basel-sh/CNN_Accelerator/Presentation/README.md

# Presentation/

Reserved for the final competition deliverable: slide deck, architecture
diagrams, and result plots (FoM, utilization, timing, power summaries),
assembled at Phase 14 - Final Report (see
`Documentation/DevelopmentRoadmap.md`). Empty until Phases 10-13 produce
real synthesis/timing/power numbers to present.
