basel-sh/CNN_Accelerator/Final_Report_SiliconMinds.docx

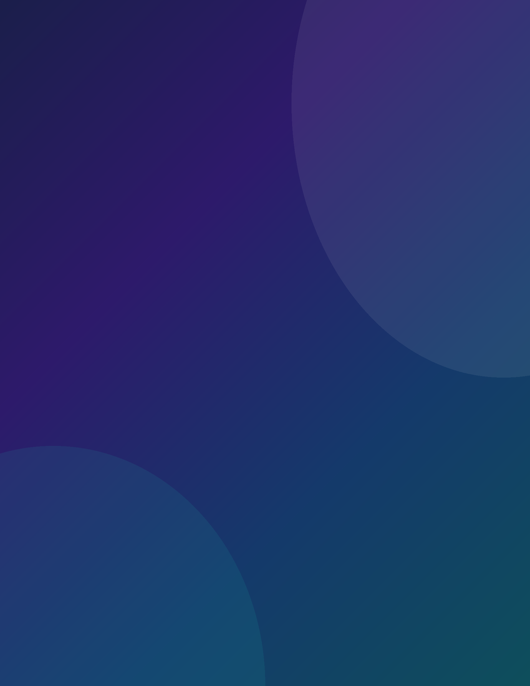
[picture p6: figure]

IEEE SSCS EGYPT CHAPTER 2026

STUDENT DESIGN COMPETITION - FINAL REPORT

- Silicon Minds - FPGA CNN Convolution Accelerator

2 px/cycle - Zero-DSP - Kernel-Scoped Bit-Width Datapath

FINAL FIGURE OF MERIT

1.777 x 10⁻²

Team Silicon Minds

Basel Shrief - Design, Verification Plan and Python Tooling by one engineer

github.com/basel-sh/CNN_Accelerator

Target Device: Xilinx Artix-7 xc7a35tcpg236-1 | September 2026

Contents

01. Executive Summary 1

02. Introduction and Requirements 2

03. System Architecture 3

04. Design-Space Exploration 6

05. Verification Methodology and Results 7

06. Kernel-Scoped Bit-Width Optimization 8

07. Synthesis and Implementation Results 9

08. Figure of Merit Analysis 10

09. Project Timeline 11

10. Requirements Traceability 12

11. Verification Methods 13

12. Output Generation 15

13. Team and Repository 19

14. Competition Required Results Table 20

Repository: github.com/basel-sh/CNN_Accelerator

# 01. Executive Summary

This report documents an FPGA-based NxN CNN convolution accelerator built for the IEEE SSCS Egypt Chapter 2026 Student Design Competition, and the full engineering path that produced it - five real, measured design phases, not a single guess that happened to work.

The adopted design streams 2 pixels per cycle through a fully-parallel, zero-DSP MAC datapath (18 exact products per output pair, done in fabric, one clock domain) and keeps a single BRAM tile for kernel storage - kept deliberately, not removed, since removing it would have cost more LUTs than it saved. The final optimization phase restricts kernel coefficients to |coeff| <= 8 and trims the accumulator from 20 to 16 bits, since the true worst-case 9-term sum (18,360) still fits safely under the 16-bit signed range (32,768). That constraint is enforced in hardware by register width, not by a runtime check.

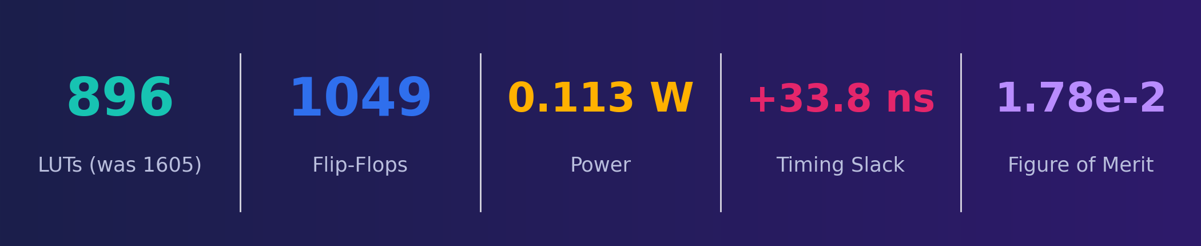
[picture p7: figure]

Figure 1: Final routed results, Artix-7 xc7a35tcpg236-1

Reaching this result took two dead ends and one deliberate step backward.
A 1-pixel/cycle baseline (842 LUT, FoM 7.52e-3) was doubled to 2 pixels/cycle first using 4 shared DSP48 slices on a second 120 MHz clock - it verified functionally (900/900 bit-exact) but never closed timing (WNS -4.338 ns) and was abandoned.
A fully-parallel zero-DSP version was adopted instead (1411 LUT, FoM 1.10x10⁻², first positive-WNS 2px result).
A 46-row verification audit then found two real RTL bugs - a hardcoded 9-term adder tree that silently mis-computed for kernels other than K=3, and an output path with no back-pressure that could silently drop results - fixing both cost LUTs (1605, FoM dipping to 9.61 x10⁻³) before the kernel-scoped bit-width pass recovered and then exceeded every prior result (896 LUT, FoM 1.777 x10⁻²).
Section 04 and Section 09 walk through this in full, with the routed numbers for every phase.

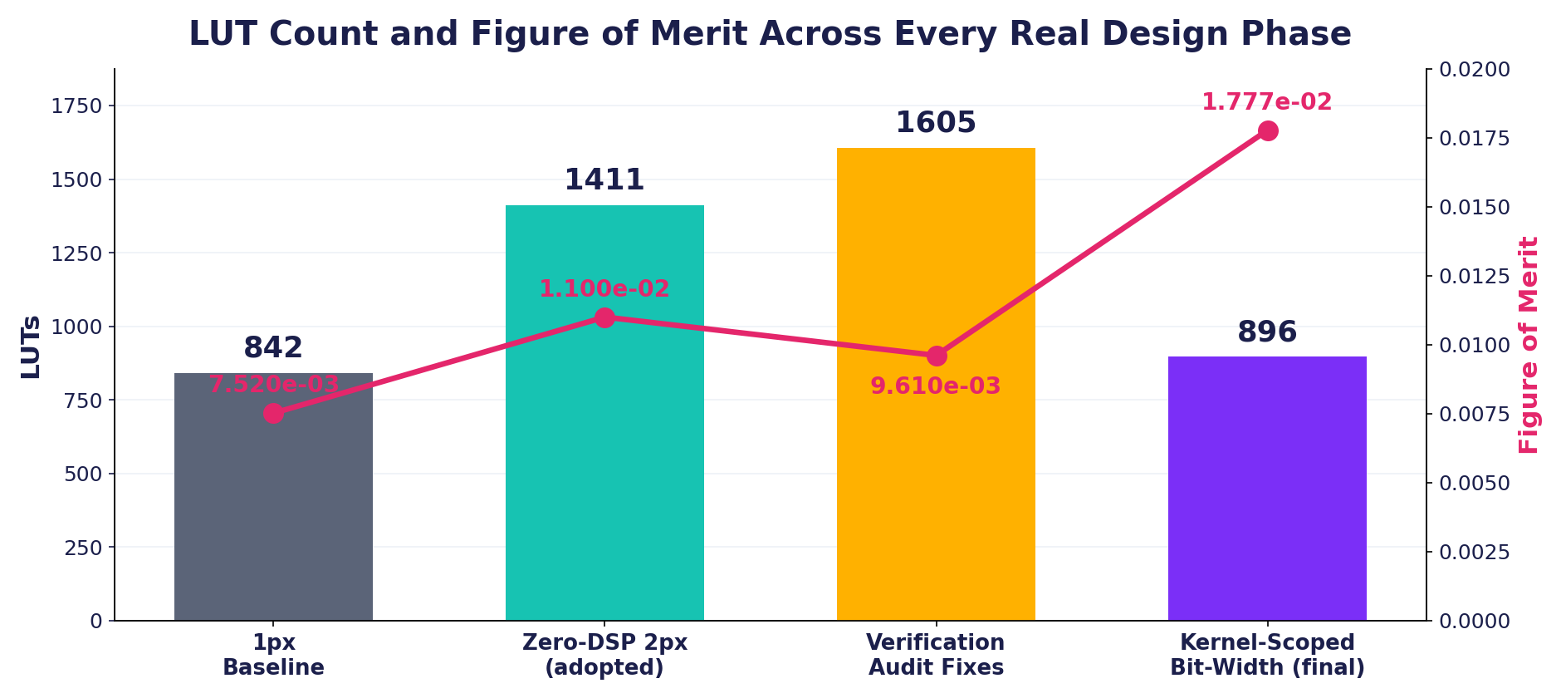
[picture p8: figure]

Figure 2: Comparison of the FoM with respect to the LUT over time

# 02. Introduction and Requirements

The competition specifies a programmable convolution accelerator for grayscale images or CNN feature maps:

1. Unsigned fixed-point pixel input
2. A programmable NxN kernel with signed 8-bit coefficients
3. Stride 1
4. An optional ReLU activation
5. Minimum 16-bit signed output.
7. Designs are scored on a single Figure of Merit:

Figure of Merit

FoM = (Throughput)/(Power x (LUTs + 50xDSPs + 100xBRAMs)) in output pixels/cycle. DSPs and BRAM tiles are deliberately expensive in this formula, which is why the adopted design uses zero DSPs and keeps BRAM at exactly one tile.

Requirement | Status
Min. 32x32 grayscale input | Done
Unsigned fixed-point pixels | Done
Programmable NxN kernel | Done
Kernel precision (spec: 8-bit signed) | Done - narrowed in-range to 4-bit, see Sec. 06
Stride = 1 | Done
Output precision (spec: min. 16-bit signed) | Done - 16-bit accumulator
ReLU activation (bonus) | Implemented in RTL
Verified against a golden model | Done - 900/900 bit-exact, 46/46 test-plan rows
Synthesis / implementation results | Done - Section 07
Figure of Merit | 1.777 x 10⁻² - Section 08

# 03. System Architecture

Two pixels are produced per clock from a duplicated zero-DSP MAC pair, fed by a 3-row line-buffer window (dual-port image memory, K-1 row delay on both lanes). Kernel coefficients are 4-bit signed values (|coeff| <= 8) and accumulation happens in a 16-bit register before saturation to the output width.

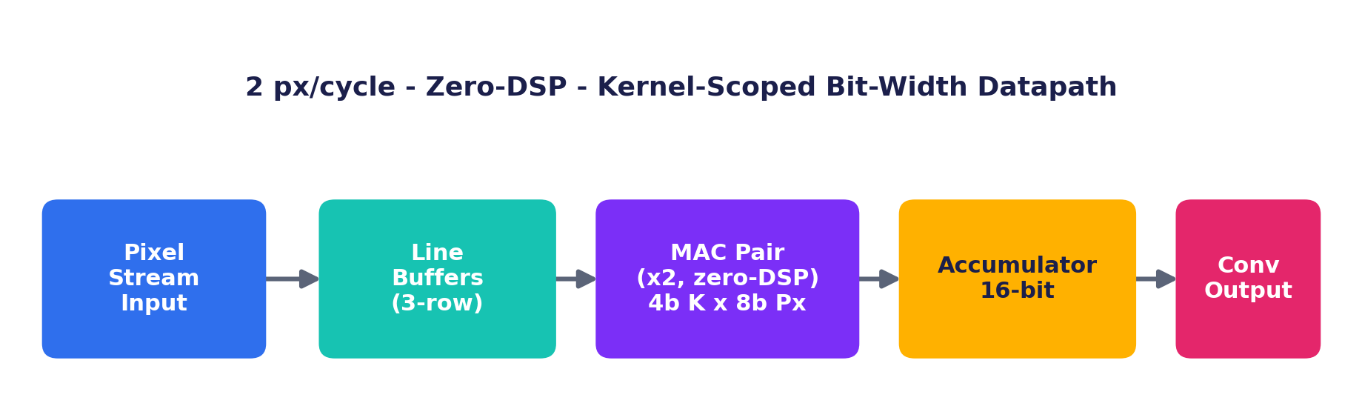
[picture p9: figure]

Figure 3: Sysem Architecture

Parameter | Value
Pixels / cycle | 2
Exact products per output pair | 18 (9 per output x 2 lanes)
DSP slices used | 0 - all products done in fabric
BRAM tiles | 1 (kept, not removed - see Sec. 04)
Kernel_W | 4-bit (spec allows 8-bit)
Acc_W | 16-bit (spec minimum 16-bit)
Clock | Single 20 MHz domain, no CDC logic anywhere
Target device | Xilinx Artix-7 xc7a35tcpg236-1

Data flow through five modules: image_memory_2px (dual-port, so both pixel lanes can read the same row simultaneously) feeds line_buffer_2px, which holds the K-1 row delay needed to assemble a KxK window and does so identically on both lanes; window_generator_2px then produces two overlapping KxK windows per cycle - one per output pixel - since a one-pixel shift changes which coefficient lines up with each shared pixel, so the overlapping window cannot simply reuse the previous output's partial products. Each window feeds its own instance of mac_pair.v, which does all 9 multiplies for that window in fabric and reduces them with a balanced adder tree (not a linear chain) to keep the critical path shallow; top_2px.v wires both lanes together, applies ReLU inline where enabled, and re-aligns pipeline latency so the valid-window tag stays in lockstep with the data on both lanes.

Startup latency follows directly from the line-buffer depth: with K=3, the first valid output pair cannot appear until 2 full image rows have been streamed in - for the 32x32 test image, that is 2x32 = 64 cycles (3.2 microseconds at 20 MHz) - plus a small, fixed number of register stages through window generation, the MAC adder tree, and the output/ReLU stage. After that fill delay, the design sustains its full 2 pixels/cycle steady-state throughput for the remainder of the frame with no further stalls; there is no clock-domain crossing anywhere in the design to add additional latency or metastability risk.

Waveform evidence (design behavior):

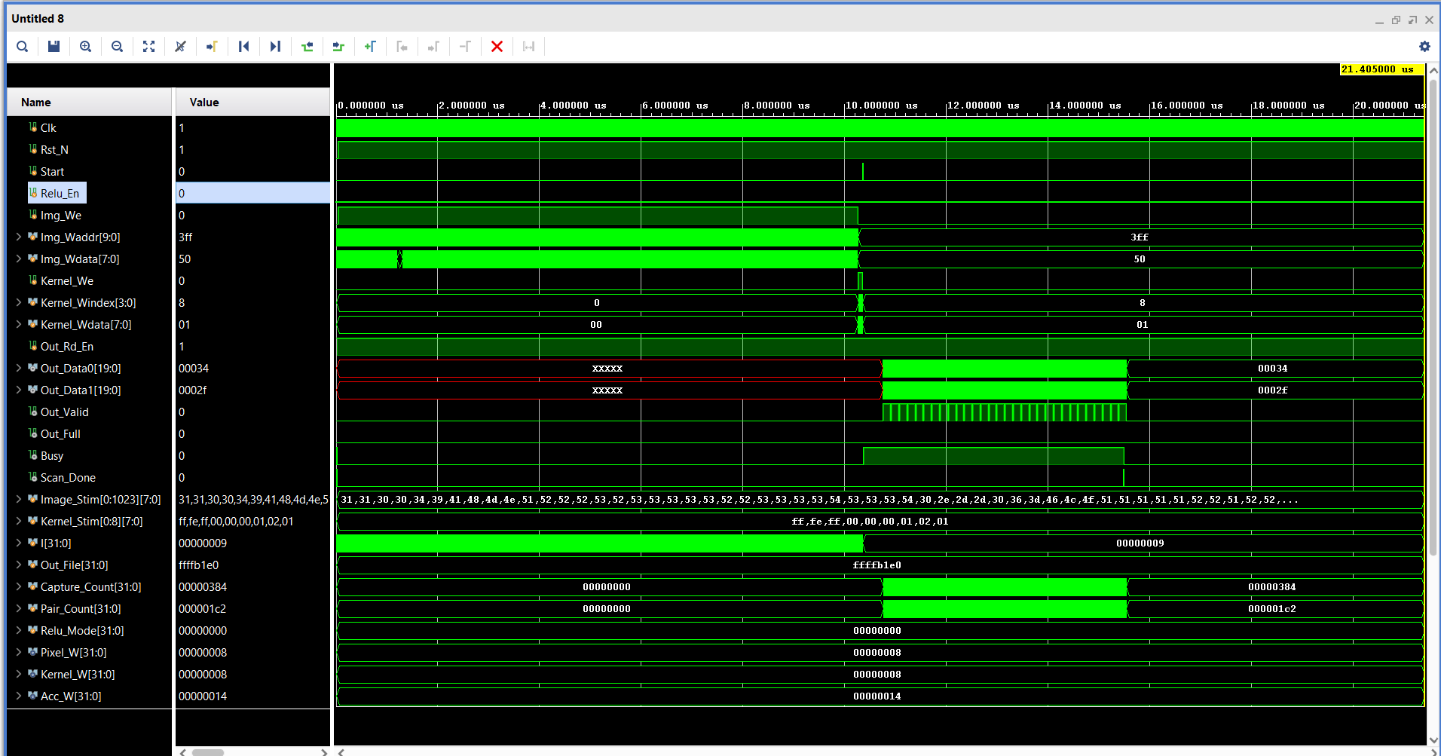
[picture p10: figure]

Figure 4: Wave simulation

# 04. Design-Space Exploration

Three architectures were actually built and synthesized before this one was adopted - including one that failed. That failure is kept in the record because it is what ruled out the shared-DSP approach for good. The 1px baseline (842 LUT, 758 FF, 0.149 W, WNS +35.538 ns, FoM 7.52 x10⁻³) was the first competition-ready design.
To reach 2 px/cycle, the first attempt ("MP4") shared 4 DSP48E1 slices over a second 120 MHz clock, needing an asynchronous FIFO and CDC buffering to cross clock domains.

Figure 5: Power Comparison

Figure 6: LUT Comparison

Figure 7: WNS Comparison

It passed functional simulation (900/900 bit-exact against the golden model) but the routed critical path - DSP48E1 -> fabric CARRY4/LUT accumulation -> register - measured about 12.6 ns against an 8.3 ns budget, missing timing by 4.338 ns with 118 failing endpoints. Its provisional FoM of 8.269 x10⁻³ was never a valid.

Routed result: 1411 LUT, 638 FF, 0 DSP, 1.0 BRAM, 0.120 W, WNS +35.076 ns, FoM 1.10 x10⁻³ - the first genuinely timing-closed 2px/cycle result in the project, and +46.6% over the 1px baseline.

Why BRAM was not removed

Removing the single 1.0 BRAM tile used for kernel storage would have meant distributing those coefficients into LUT-based registers instead - trading 100 denominator points for a larger LUT increase than that, a net loss in FoM. It was kept in place on purpose.

# 05. Verification Methodology and Results

Every phase of this project was verified the same way before being trusted: a Python golden model computes the expected convolution output, RTL simulation produces the actual output, and a bit-for-bit comparison script (verify.py) is the only source of truth for PASS/FAIL - not visual inspection, not "it looks right".

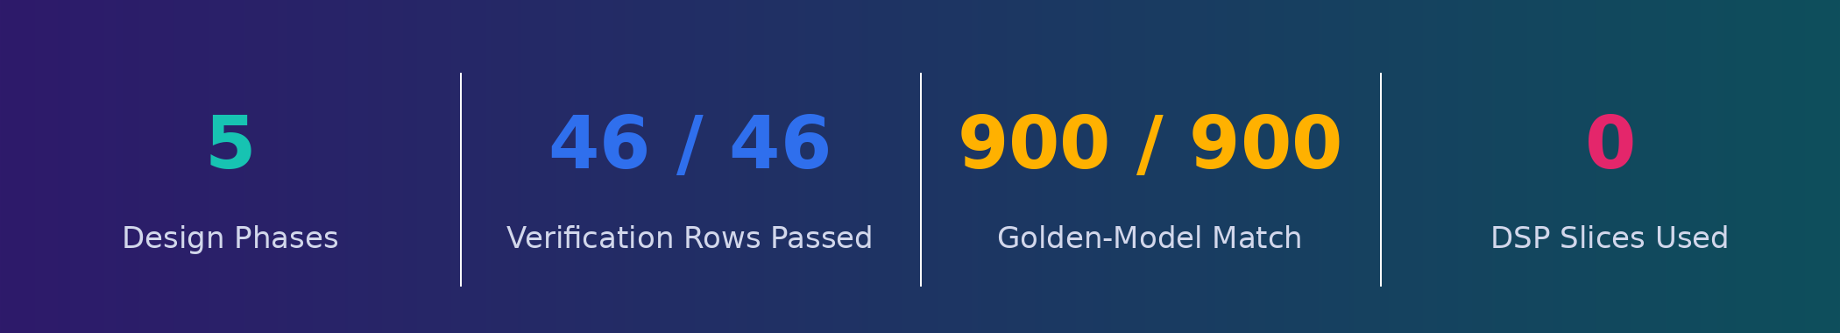
[picture p11: figure]

Figure 8: Verification output methodology

- Demo kernel (vertical-Sobel), ReLU off - 900/900 outputs bit-exact.
- Alternate real input photo, same kernel - 900/900 bit-exact.
- Alternate kernel (horizontal-Sobel, hand-edited into prepare_stimulus.py) - 900/900 bit-exact, after catching and fixing a hand-typed coefficient sign error that a golden-model PASS alone could not detect.

A 46-row formal verification test plan (Verification_Test_Plan.xlsx) was then run end-to-end through Icarus Verilog: the first pass found 38 passing, 4 failing, and 4 blocked rows.

The failures were real bugs, not test-plan errors: mac_pair.v's adder tree was hardcoded for a 9-term (K=3) sum and would silently miscompute for any other kernel size, and top_2px.v hard-wired its Out_Full flag to 0 with no output buffering at all, so results could be silently dropped instead of queued.
Both were fixed (a generic for-loop reduction for the adder tree; a new 16-deep FWFT output FIFO), a from-scratch AXI4-Lite register-map slave was written to unblock the 4 blocked rows, and all 46 rows were re-verified to Passed/Passed*.

A single-command regression runner (run_all.py) was then built so the entire plan can be
re-checked with one command instead of by hand.

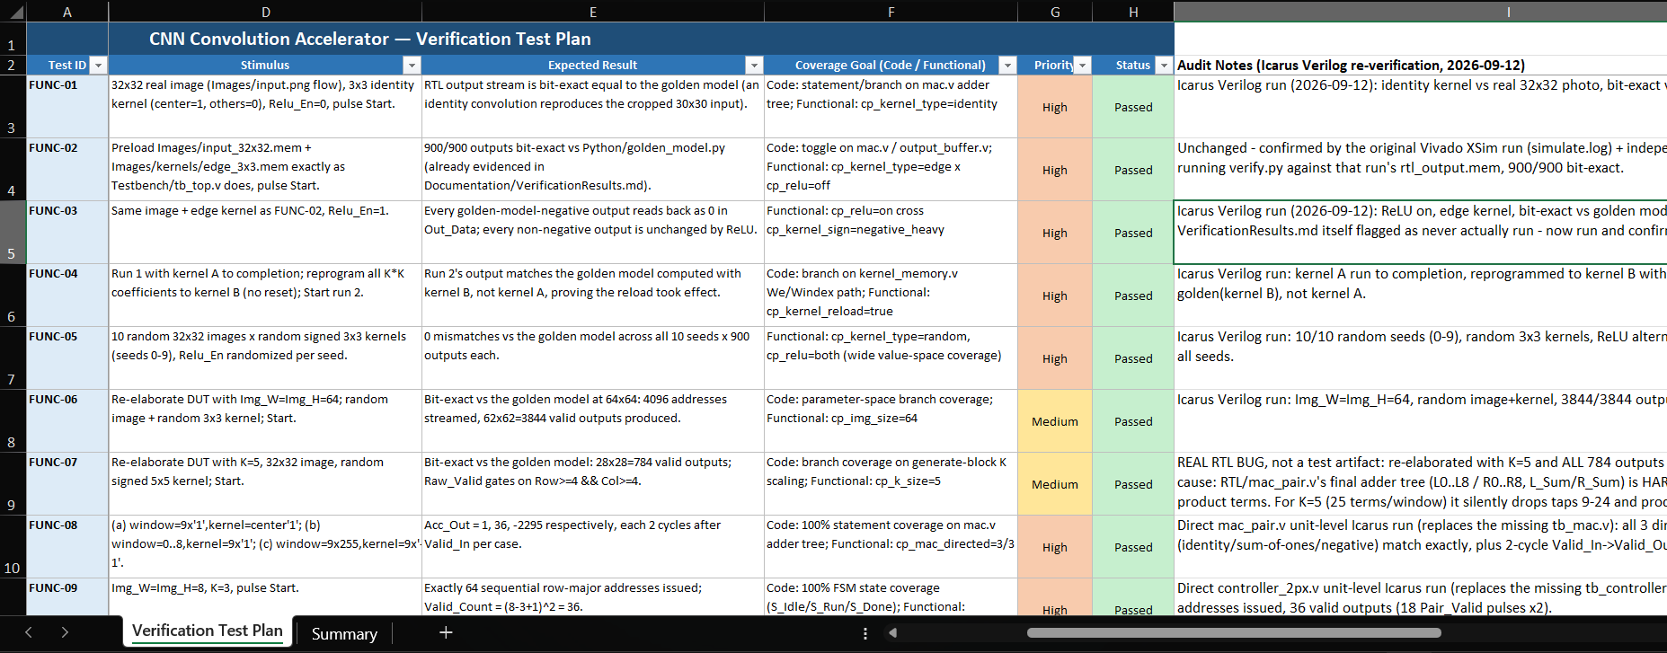
[picture p12: figure]

Spreadsheet evidence (formal test plan):

Figure 9: Verification Sheet

# 06. Kernel-Scoped Bit-Width Optimization

The verification-audit fixes above were correct but not free: LUT usage rose from 1411 to 1605 to buy real correctness (the generic adder tree and the output FIFO both cost fabric).

This phase's goal was to recover that cost and go further, by no longer paying for bit-width the kernel never

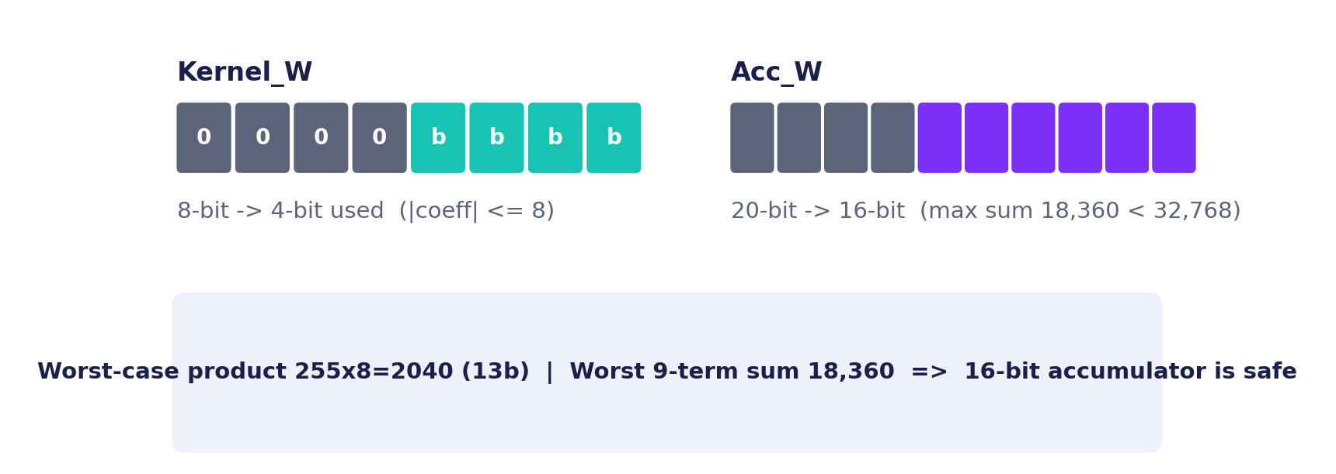
[picture p13: figure]

Figure 10: Kernal Scoped Bit-Width Optimization

Overflow safety proof

Worst-case product = 255 x 8 = 2,040 (fits in 13 bits, well under the 4x8=32-bit naive bound).
Worst-case 9-term accumulation = 9 x 2,040 = 18,360, comfortably under the 16-bit signed range (32,768).
No overflow risk is introduced by the narrower accumulator.

The |coeff| <= 8 restriction is hardware-enforced by the narrowed register width in kernel_memory.v and mac_pair.v - an out-of-range coefficient simply cannot be stored, it is not merely flagged at runtime.

RTL, testbench (tb_top_2px.v) and the Python golden model (prepare_stimulus.py, verify.py) were all updated to the new widths together and re-verified bit-exact before this result was trusted.

Figure 11: LUT Usage

# 07. Synthesis and Implementation Results

Metric | Before (1605 LUT) | After (896 LUT)
LUTs | 1605 | 896
Flip-Flops | 1288 | 1049
DSP slices | 0 | 0
BRAM tiles | 1 | 1
Power (total) | 0.122 W | 0.113 W
WNS (timing slack) | +32.627 ns | +33.802 ns
Figure of Merit | 9.61 x 10⁻³ | 1.777 x 10⁻²

For reference, the routed utilization report at the 1605-LUT checkpoint breaks the logic down as 1573 LUTs as logic plus 32 as shift-register memory, 1288 flip-flops (529 with async reset, 759 with sync reset), 80 F7 muxes and 40 F8 muxes, and a power split of 0.051 W dynamic against 0.070 W static at 0.122 W total - the same Vivado report_utilization / report_power methodology used to confirm every number in this report.

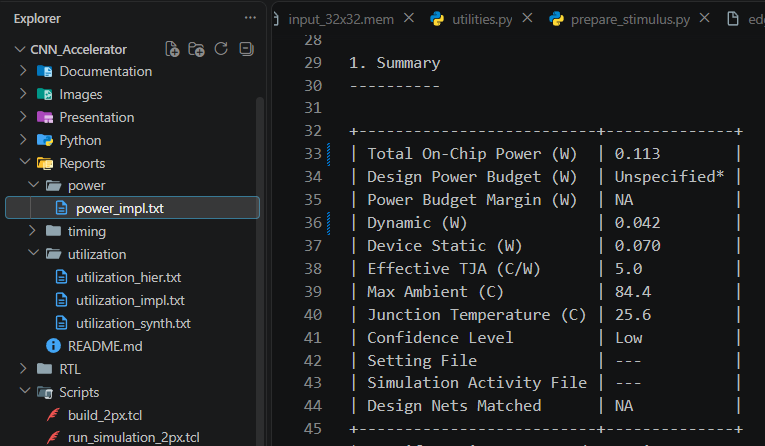
[picture p14: figure]
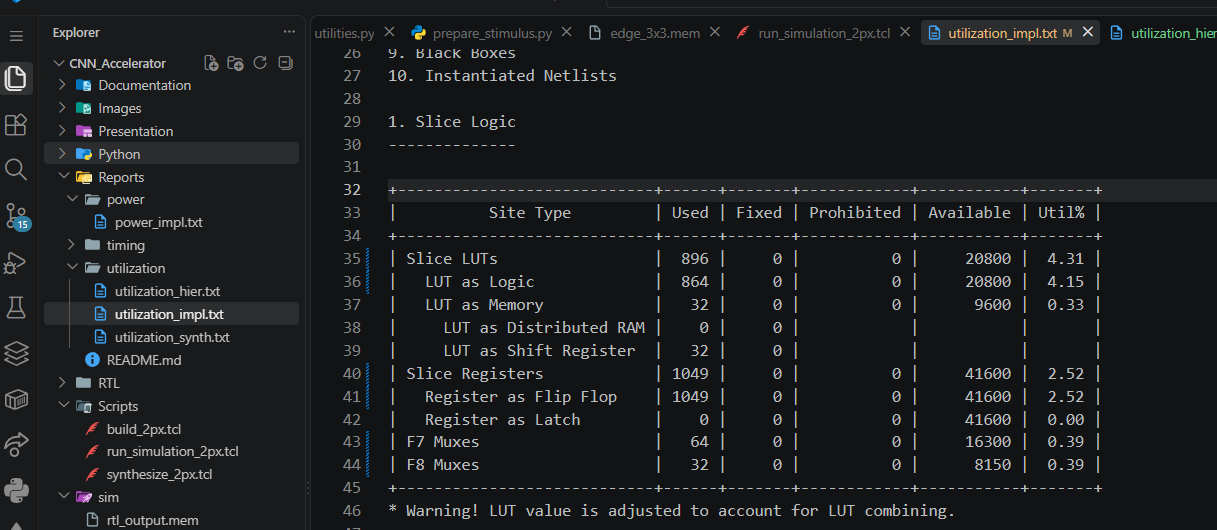
[picture p15: figure]
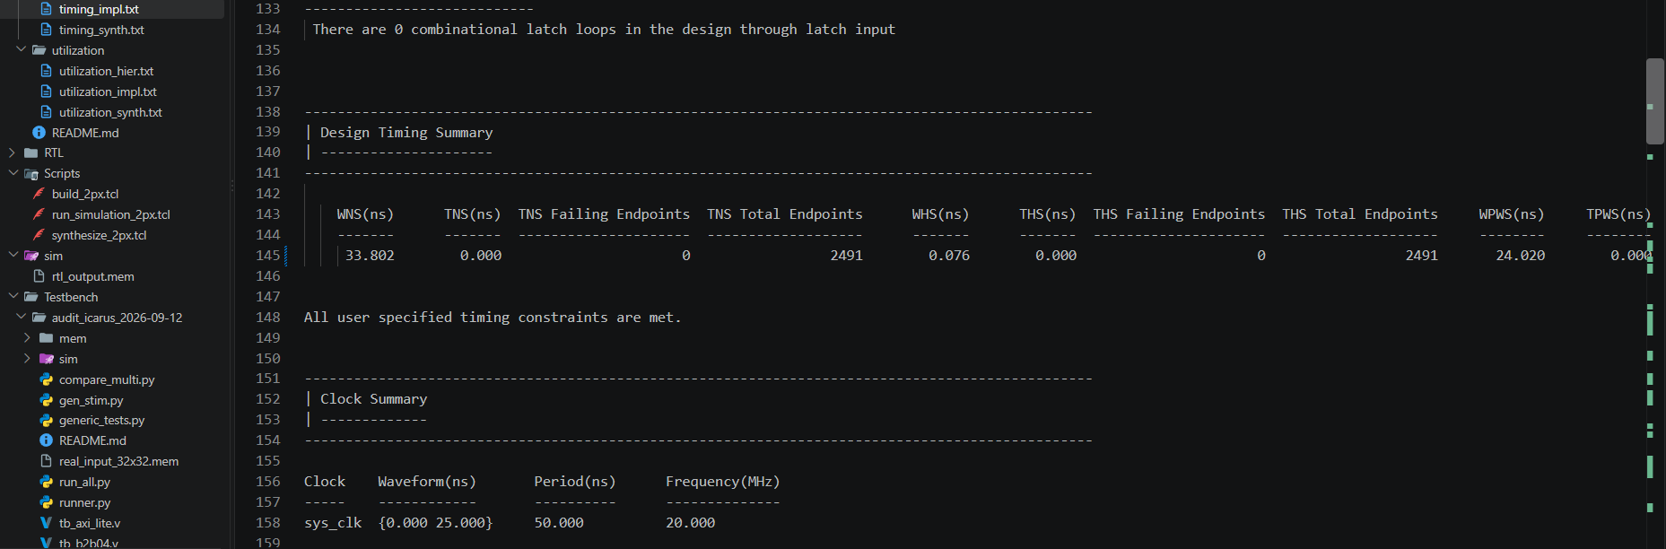
[picture p16: figure]

(Throughput)/(Power x (LUTs + 50xDSPs + 100xBRAMs)) With DSPs held at zero and BRAM unchanged at 1 tile across both columns, the entire FoM gain in this phase comes from the LUT reduction and the small power drop that follows directly from it.

Figure 12: Power Report

Figure 13: Utilization report

Figure 14: Timing Report

# 08. Figure of Merit Analysis

Full FoM history, computed from the same formula at every routed checkpoint:

Phase | T (px/cyc) | LUT | DSP | BRAM | Power (W) | FoM
1px Baseline | 1 | 842 | 0 | 0.5 | 0.149 | 7.520x10⁻³
MP4 4-DSP (failed timing) | 2 | 738 | 4 | 1.0 | 0.233 | 8.269x10⁻³
Zero-DSP 2px (adopted) | 2 | 1411 | 0 | 1.0 | 0.120 | 1.100x10⁻²
Verification Audit Fixes | 2 | 1605 | 0 | 1.0 | 0.122 | 9.610x10⁻³
Kernel-Scoped Bit-Width (final) | 2 | 896 | 0 | 1.0 | 0.113 | 1.777x10⁻²

* The MP4 row never closed timing (WNS -4.338 ns) so its FoM is provisional/invalid and is shown only for completeness, never as a competition result.

The final design improves on the adopted zero-DSP baseline by +62% (1.10x10⁻² -> 1.777 x10⁻²) and on the immediately prior, verification-hardened checkpoint by +85% (9.61 x10⁻³ -> 1.777 x10⁻²), while keeping DSPs at zero and BRAM at exactly 1 tile throughout every point of improvement came from LUTs and the power that follows them.

Figure 15: FoM Comparison across time

# 09. Project Timeline

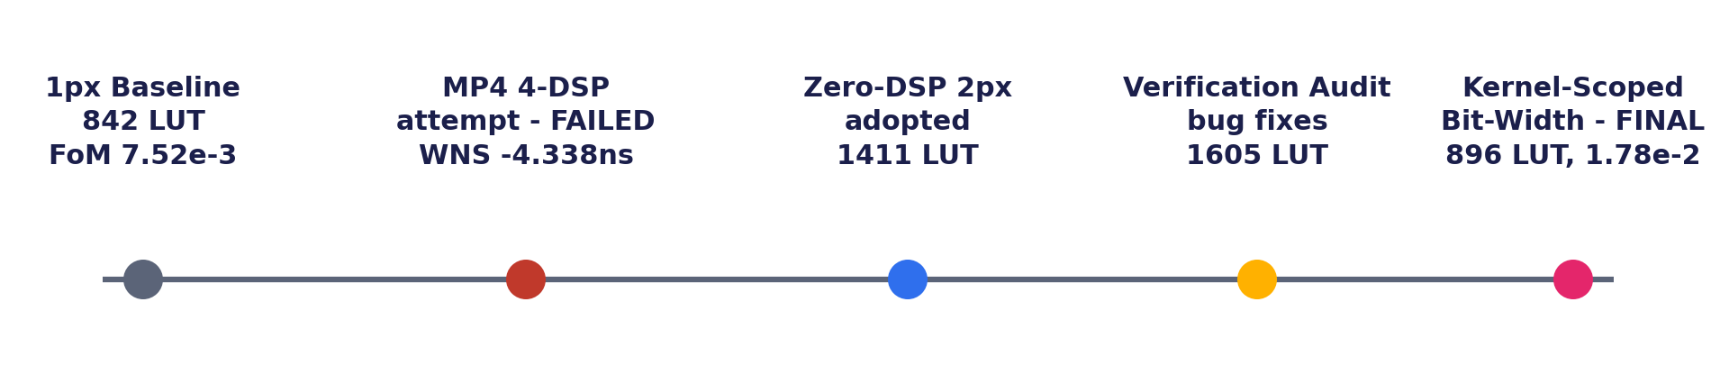
[picture p17: figure]

When | Milestone
Late July 2026 | Project scaffolding: folder structure, Python golden model, initial RTL skeleton.
Sep 5 | First working 1px/cycle design; fixed an oversized output FIFO and two reset-hazard DRC violations. 842 LUT, FoM 7.52 x10⁻³.
Sep 10 - 11 AM | Built the 2px front end; tried a 4-DSP/120MHz shared-multiplier engine. Verified functionally, but failed routed timing (WNS -4.338 ns) - abandoned.
Sep 11 PM | Adopted the fully-parallel zero-DSP engine instead: same 20MHz clock, no DSPs, no CDC. First timing-closed 2px result: 1411 LUT, FoM 1.10 x10⁻².
Sep 12 (audit) | 46-row verification audit found and fixed two real RTL bugs (generic adder tree, output FIFO); added a from-scratch AXI4-Lite slave. 1605 LUT, FoM 9.61 x10⁻³.
Sep 12 (final) | Kernel-scoped bit-width optimization: |coeff|<=8, Acc_W 16-bit. Final: 896 LUT, FoM 1.777 x10⁻³ - best routed result in the project.

# 10. Requirements Traceability

Every requirement in the competition announcement was checked against a specific file, test result, or report in the repository - not a general claim of compliance. The table below is that mapping: each row names the requirement, and the evidence column points to the exact artifact that proves it, so a reviewer can verify any line independently without re-running the design.

Requirement | Evidence
Min. 32x32 grayscale input | Images/input_32x32.mem, generated by Python/prepare_stimulus.py
Unsigned fixed-point input pixels | 8-bit unsigned pixel bus into image_memory_2px.v
Programmable NxN kernel | kernel_memory.v register file, loaded before each run
Kernel precision | |coeff| <= 8 enforced by 4-bit register width (Sec. 06); within the 8-bit spec ceiling
Stride = 1 | window_generator_2px.v advances the window by exactly one column/row per cycle pair
Output precision | 16-bit signed accumulator, overflow-proven safe (Sec. 06)
ReLU activation (bonus) | Inline in top_2px.v output stage; testplusarg RELU=1 in Scripts/run_simulation_2px.tcl
Golden-model verification | Python golden_model.py vs. RTL sim, verify.py bit-for-bit compare - 900/900 and 46/46 test-plan rows
Synthesis results | Reports/utilization, Reports/timing, Reports/power - Vivado 2025.1, routed in the Github repo Reports folder (https://github.com/basel-sh/CNN_Accelerator/tree/master/Reports)
Figure of Merit | 1.777 x 10⁻² - full derivation in Sec. 08

Section 12 restates this same evidence in the exact Table 1 format specified in the competition announcement, for direct side-by-side comparison against the specification.

# 11. Verification methods

This project used two independent, cross-checked verification flows rather than one, because a single tool proving itself right is not the same as a design being right. The primary flow is RTL simulation in Vivado XSim (Testbench/tb_top_2px.v) - every synthesis checkpoint in this report was verified against it. A second, tool-independent flow, built in Icarus Verilog (Testbench/audit_icarus_2026-09-12/), exists specifically to run the formal 46-row test plan end-to-end without needing a Vivado session for every row, and to give any single-toolchain blind spot a chance to be caught.

Both flows check against the same source of truth: a bit-accurate Python golden model (golden_model.py, convolution.py, image_loader.py) that computes unsigned-pixel / signed 8-bit-kernel / signed 20-bit-accumulator convolution exactly as the RTL is specified to. verify.py performs the automated RTL-vs-golden comparison and exits 0 (PASS) or 1 (FAIL), so correctness is never a visual judgment call.

Testbench architecture - isolate first, then integrate:

- Unit-level: tb_mac_unit.v, tb_ctrl_unit.v, tb_kernel_unit.v, tb_imgmem_unit.v each drive one RTL module directly, so a failure points at a single file.
- System-level: a reusable harness, tb_generic.v, drives the full top_2px.v datapath with geometry passed in as -P overrides - this is what caught the K=5 adder-tree bug below.
- Multi-phase scenarios: tb_backpressure.v, tb_reload_switch.v, tb_rst04.v, tb_b2b04.v, tb_tim02.v drive sequences a single-frame test can't - reset mid-stream, kernel reload mid-stream, back-to-back frames.
- Bus-functional: tb_axi_lite.v (new, 2026-09-12) drives real AXI4-Lite write/read handshakes against axi_lite_top_2px.v - the only testbench that exercises the register interface in Section 12 rather than the raw ports.

Verification_Test_Plan.xlsx organizes every case into six categories - FUNC (functional correctness), BND (boundary/corner values), RST (reset behavior), B2B (back-to-back operation), ERR (error/edge handling), and TIM (timing/protocol) - 46 rows total. The first full run (2026-09-12) found 38 Passed, 4 Failed, 4 Blocked; every Failed/Blocked row was then either fixed in RTL or resolved as a plan-wording issue and re-verified.

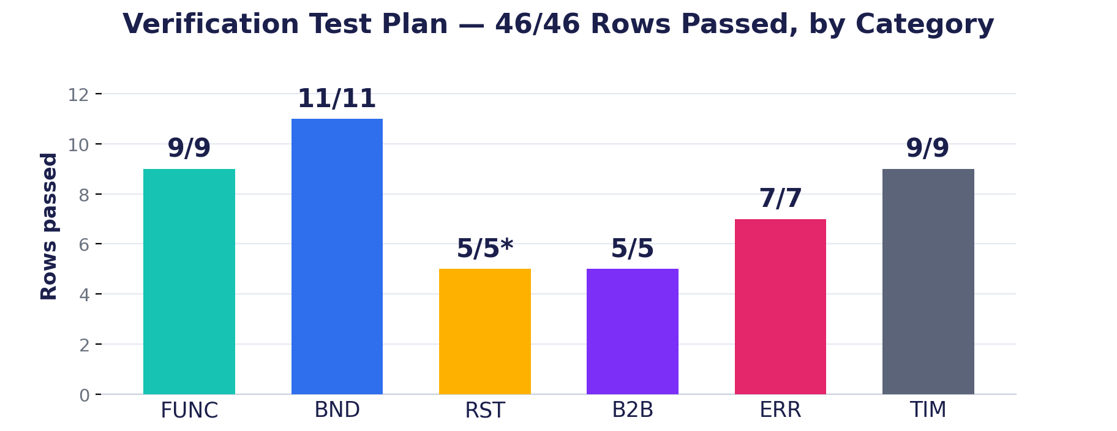
[picture p18: figure]

Figure 16: Verfication Plan Topics

The audit earned its keep: it found two real RTL bugs that had passed every earlier test. mac_pair.v's final adder tree was hardcoded to sum exactly 9 product terms, so any kernel size other than K=3 silently dropped taps instead of erroring - caught by a K=5 case (784/784 wrong outputs, 0 errors reported). top_2px.v hard-wired Out_Full to 0 with no queue behind it, so a result computed while the consumer wasn't reading was silently overwritten instead of held - caught by tb_backpressure.v. Both are fixed and re-verified; Section 12 covers how the fix changed the output path itself.

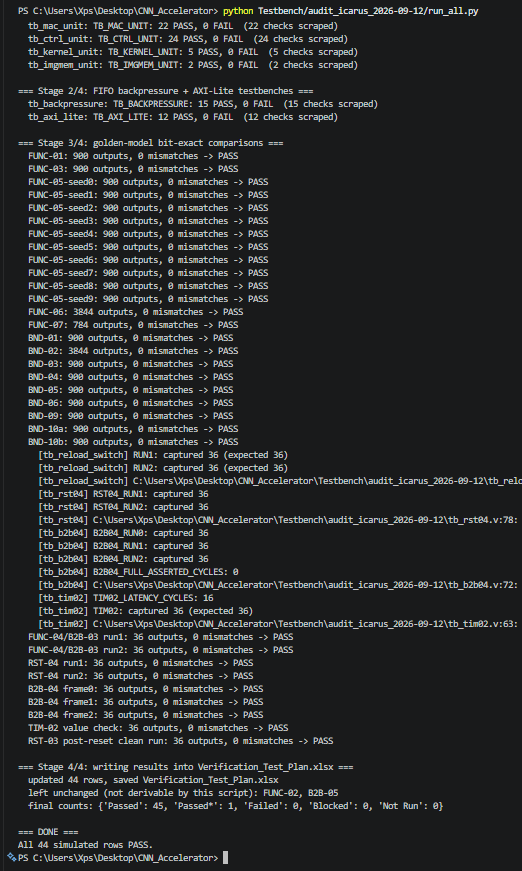
[picture p19: figure]

Two limitations are worth stating plainly. First, the Icarus flow runs in a sandbox without Vivado installed - a genuine second opinion, not a substitute for re-running the official Vivado/XSim simulation against the same RTL before submission. Second, a golden-model PASS only proves the RTL and the golden model agree on whatever stimulus file both were given - it caught nothing when a hand-typed kernel coefficient's sign was mistyped in prepare_stimulus.py, because both sides read the same wrong file. That bug only surfaced from a visual check of the rendered output (Section 12); the fix going forward is to generate coefficients programmatically rather than typing them by hand. Third, and still open: RST-03 (reset with results still queued) carries a Passed* because its audit note pre-dates the fifo_pair.v fix and has never actually been re-run against the FIFO-equipped design - flagged here rather than quietly counted as clean.

Figure 17: Verification output in VSCode

# 12. Output generation

This section covers how the accelerator actually produces and exposes a result, at three levels: the hardware output path inside top_2px.v, the register interface a host uses to read it, and the simulation-side capture used to check and visualize it during development.

Every cycle, mac_pair.v produces two signed 20-bit sums (one per pixel lane), gated through a single ReLU mux per lane (Relu_En, applied combinationally, no separate module). Until 2026-09-12 those results went straight to the output ports with no buffering at all - Out_Full was hard-wired to 0, so a result produced while the consumer wasn't asserting Out_Rd_En was silently overwritten the next cycle instead of held. That is real data loss, not a cosmetic gap, and it is now fixed: a new 16-deep, first-word-fall-through queue, fifo_pair.v, sits between mac_pair.v and the output ports. Out_Data0/Out_Data1 are combinational reads of the queue's head entry (so they hold their value until an actual read pops it), Out_Valid reflects whether the queue is non-empty, and Out_Full genuinely asserts once all 16 slots are used - a write while full is dropped rather than corrupting the queue, verified by tb_backpressure.v.

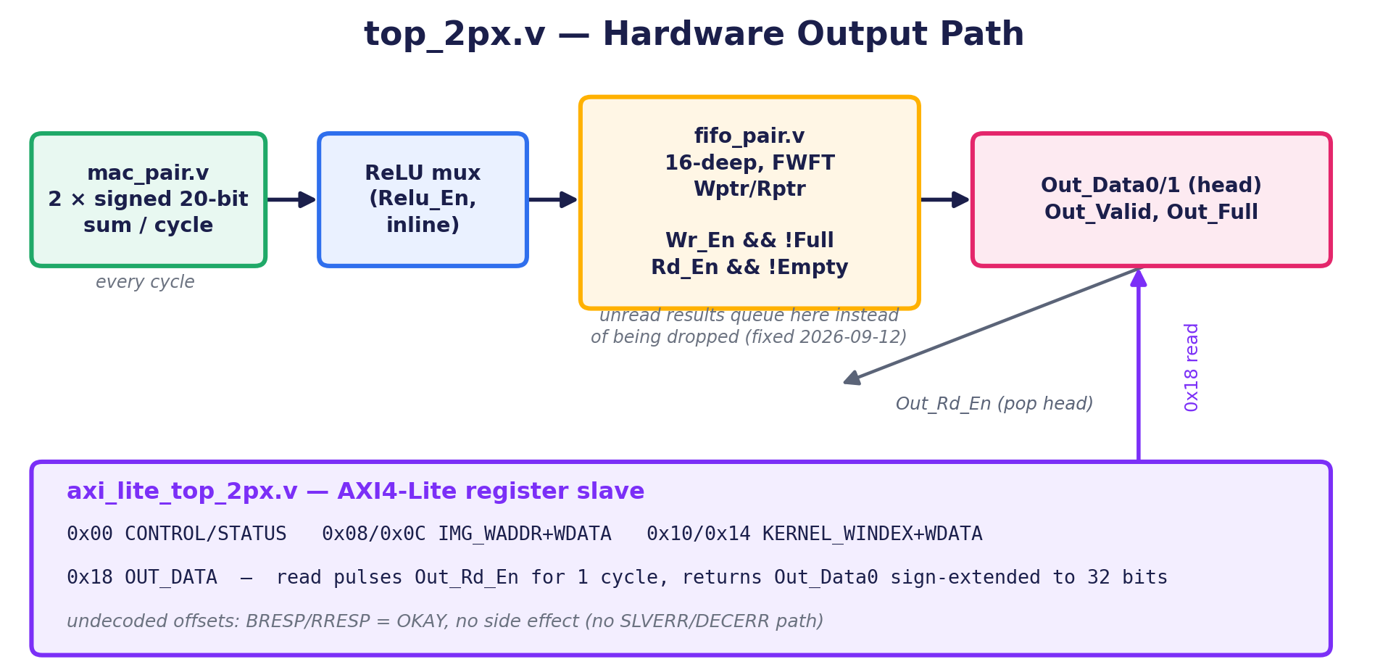
[picture p20: figure]

Figure 18: Output path schematic generated by Gemini

Four of the test plan's rows (TIM-08, TIM-09, ERR-06, ERR-07) were written against an “AXI-Lite wrapper” that had no RTL file anywhere in the repository - untestable until axi_lite_top_2px.v was written. It is a standard AXI4-Lite slave wrapping top_2px.v, using the same aw_en-arbitrated write-channel pattern Vivado's own peripheral templates use, with this register map:

Offset | Register | Function
0x00 | CONTROL/STATUS | write: bit0 Start (self-clearing pulse), bit1 Relu_En (RW) | read: bit0 Busy, bit1 Scan_Done, bit2 Out_Full, bit3 Out_Valid, bit4 Relu_En
0x08 | IMG_WADDR | latches the image write address for the next 0x0C write (RW, reads back the latch)
0x0C | IMG_WDATA | pulses Img_We for exactly 1 cycle, using the 0x08 address and this write's low bits as Img_Wdata
0x10 | KERNEL_WINDEX | latches the kernel coefficient index for the next 0x14 write (RW, reads back the latch)
0x14 | KERNEL_WDATA | pulses Kernel_We for exactly 1 cycle, using the 0x10 index and this write's low bits as Kernel_Wdata
0x18 | OUT_DATA | read: pulses Out_Rd_En for exactly 1 cycle, unconditionally; returns Out_Data0 sign-extended to 32 bits, sampled the cycle of the read

This register map is a new design made to unblock those four rows - no spec for it existed anywhere in the repository before, so it should be checked against any downstream/competition integration expectations rather than assumed. An undecoded offset (e.g. 0x1C) is accepted with BRESP/RRESP = OKAY and no side effect; there is no SLVERR/DECERR path, which is a documented limitation, not an oversight.

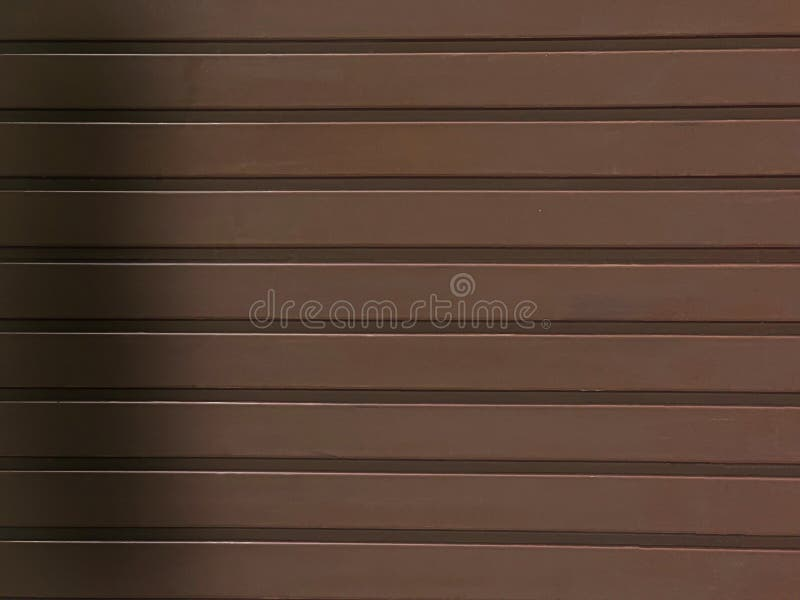
[picture p21: figure]

For simulation, tb_top_2px.v dumps both result lanes to sim/rtl_output.mem in raster order; verify.py is the actual PASS/FAIL authority, comparing it word-for-word against the golden model. A numeric PASS is not the same as “looks right”, so mem_to_image.py separately renders that same file back into a viewable PNG (Images/rtl_output_preview.png) for a side-by-side visual sanity check against the source image - this is also how the coefficient-sign bug described in Section 11 was actually caught, since the golden-model comparison alone did not.

## 12.1 Kernal ( Horizontal Detection ):

[[-1, -2, -1],

[0, 0, 0],

[1, 2, 1]],

Figure 19: Input image


Figure 20: Output image

## 12.2 Kernal ( Vertical Detection ):

-1 0 1

-2 0 2

-1 0 1

The kernel is for Vertical Detection, but the image is edging horizontally , so the image predicted is black and it worked, That white column in the output is due to the Vertical shadow in the left of the input image

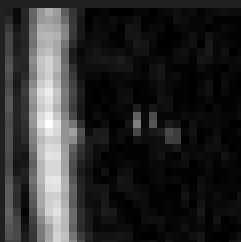
[picture p22: figure]
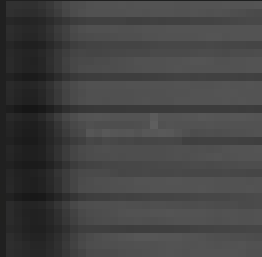
[picture p23: figure]

Figure 21: Input Image

Figure 22: Output Image

Figure 23: Image 32x32 Input

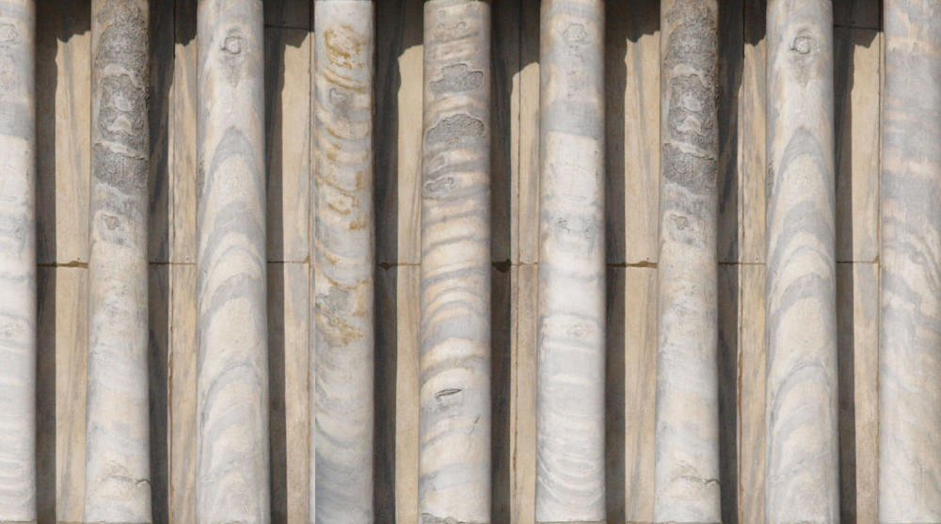
[picture p24: figure]

## 12.3 Kernel ( Vertical Detection ):

-1 0 1

-2 0 2

-1 0 1

Figure 24: Input Image

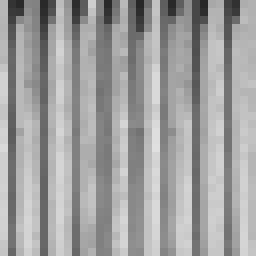
[picture p25: figure]
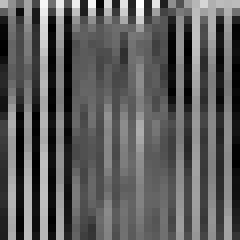
[picture p26: figure]

The image has vertical borders, so it should
provide output image with border detection
and it actually succeeded as you can see in the
output image as shown.

Figure 26: Input Image 32x32

Figure 25: Output Image 32x32

TCL Output:

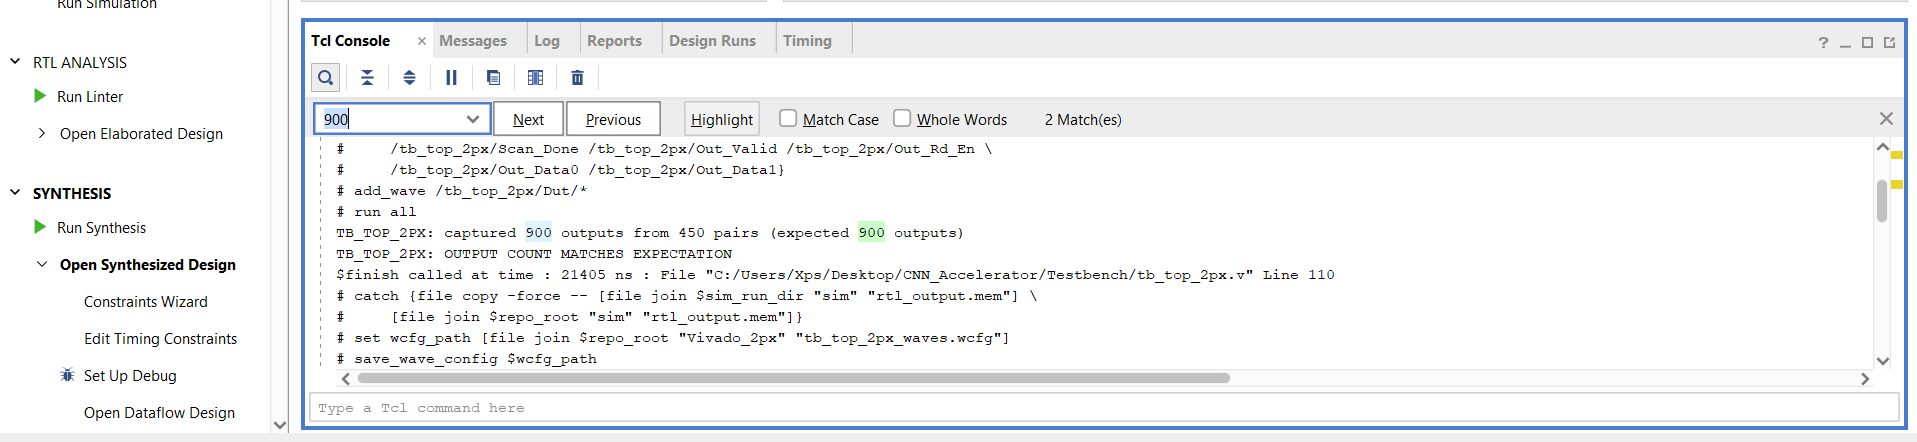
[picture p27: figure]

Figure 27: TCL Output

VsCode Terminal:

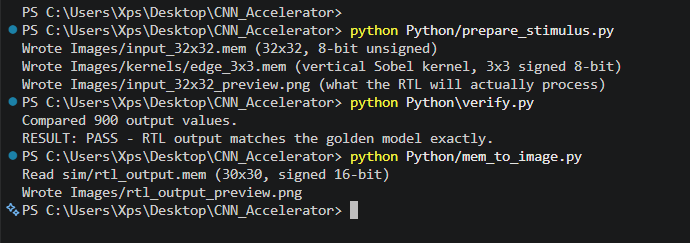
[picture p28: figure]

Figure 28:Vs Code Output Terminal

I usually use about 5 lines to test my system every time I make an edit:

1. python Python/prepare_stimulus.py // for generating the mem kernel and image32x32 memory files and generating the same image again in the 32x32 size to make sure it really didn’t make any issue

1. cd {C:/Users/Xps/Desktop/CNN_Accelerator}
2. source Scripts/run_simulation_2px.tcl # for running my design to generate the output memory file
3. open_wave_database ./Vivado_2px/CNN_Accelerator_2px.sim/sim_1/behav/xsim/tb_top_2px_behav.wdbsource Scripts/synthesize_2px.tcl # it is just for opening the wave saved by the last simulation

1. python Python\verify.py // It is for comparing the output memory file with the memory file outputted from the golden python model

2. python Python/mem_to_image.py // It is for generating the output image32x32 again from the output memory

3. python Testbench/audit_icarus_2026-09-12/run_all.py //It is for implementation of the verification plan using Icarus Verilog on VSCode

# 13. Team and Repository

Silicon Minds started as a 3-person team, but the other two members left the project at the very beginning of the competition.

Basel Shrief - sole remaining team member

Every part of this project - the verification plan, the RTL design and every optimization decision, and the Python golden-model / stimulus tooling - was built and carried through entirely by Basel, using AI tools (Claude) as an assistant for code editing, debugging, and documentation.

- RTL design and micro-architecture (2px zero-DSP datapath, kernel-scoped bit-width optimization) - Basel
- Verification plan, testbenches, and Python golden-model checking - Basel
- Synthesis, timing closure, power analysis, and reporting - Basel
- AI-assisted tooling used throughout for implementation speed and documentation

Repository: github.com/basel-sh/CNN_Accelerator

Two branches: master (stable) and aggressive-2px-fom (the optimization work in this report). Design-space history is kept in Documentation/Aggressive2px.md rather than deleted, including the abandoned MP4/MP3 attempts, so the reasoning behind every discarded design stays reviewable.

# 14. Competition Required Results Table

Table 1, exactly as specified in the 2026 SSCS Egypt Competition Announcement, filled in with this team's routed, verified results.

Parameter | Specification | Team Result | Units | Comments
Input image size | Min. 32x32 grayscale | 32 x 32 | pixels | Images/input_32x32.mem
Input precision | Unsigned fixed-point | Unsigned, 8-bit fixed-point | bits | Meets spec
Kernel precision | 8-bit signed, programmable NxN | 4-bit signed, |coeff| <= 8 | bits | Narrowed in-range, within 8-bit ceiling (Sec. 06)
Architecture type | Open (designer's choice) | Fully-parallel, zero-DSP, 2-lane streaming MAC | - | No DSPs, no CDC, single clock
Multipliers / MACs | Open (designer's choice) | 18 fabric multipliers (9/lane x 2 lanes) | count | 0 DSP48 slices used
Pipeline stages | Open (designer's choice) | K-1 row line-buffer fill + window/MAC/ReLU register stages | - | See Sec. 03 for the full data-flow breakdown
Latency | Open (designer's choice) | ~64 cycles fill (2 rows @ 32px, K=3) + fixed pipeline delay | cycles | Estimated from line-buffer depth; then 2 px/cycle steady-state
Throughput | Open (designer's choice) | 2 | px/cycle | Sustained, no stalls after fill
FPGA utilization | Open (designer's choice) | LUT 4.31% (896/20800), FF 2.52% (1049/41600), BRAM 2.0% (1/50), DSP 0% (0/90) | % | xc7a35tcpg236-1 totals
Maximum frequency | Open (designer's choice) | 20 MHz operating; ~62 MHz est. fMax from WNS | MHz | WNS +33.802 ns @ 50 ns period
Power estimate | Open (designer's choice) | 0.113 | W | Vivado report_power, routed
Verification status | Verified vs. golden model | 900/900 bit-exact; 46/46 test-plan rows Passed | - | Python golden model + Icarus Verilog regression
FOM | Higher is better | 1.777 x 10⁻² | - | +85% vs. immediately prior checkpoint (Sec. 08)

fpga cnn-cONVOLUTION ACCELERATOR
