basel-sh/CNN_Accelerator/Presentation/fig1_block_diagram.png

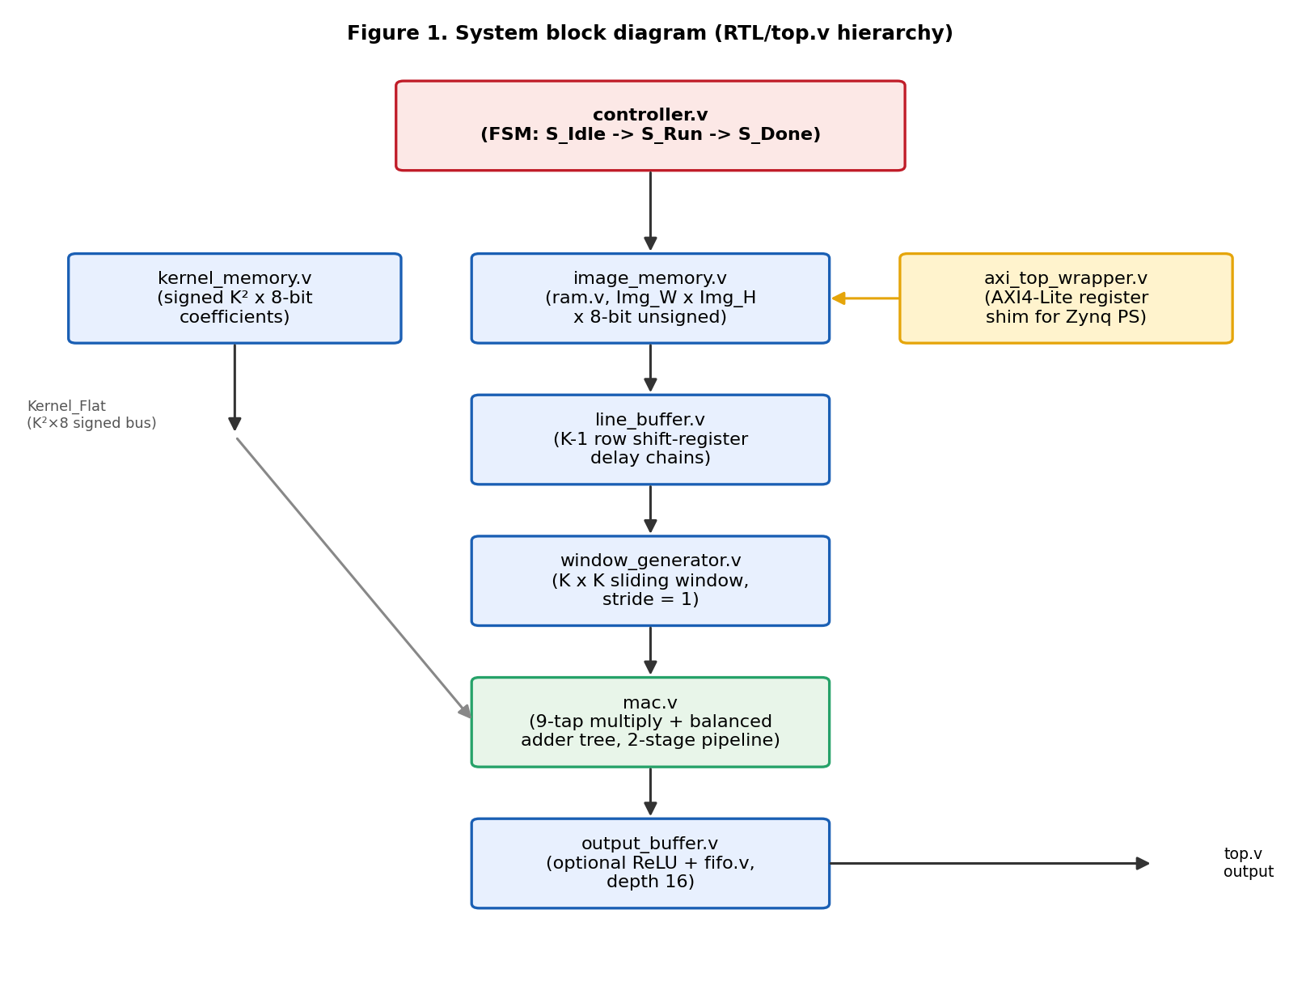
Presentation/fig1_block_diagram.png
