basel-sh/CNN_Accelerator/Presentation/fig2_fsm_diagram.png

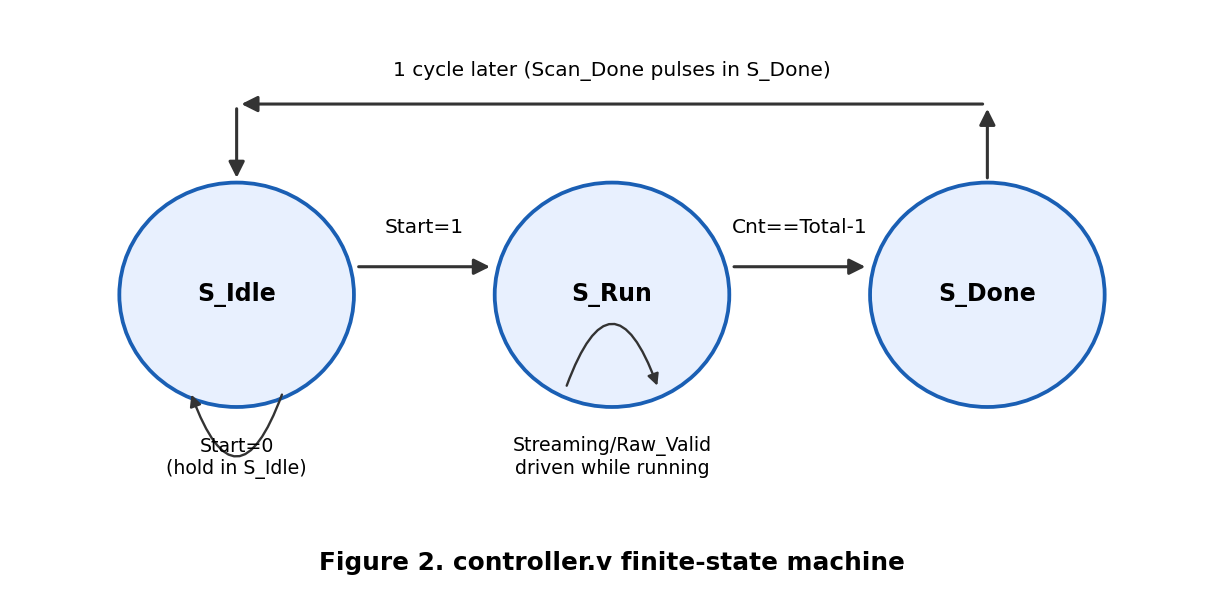
Presentation/fig2_fsm_diagram.png
