basel-sh/CNN_Accelerator/Presentation/waveform_scan_done.png

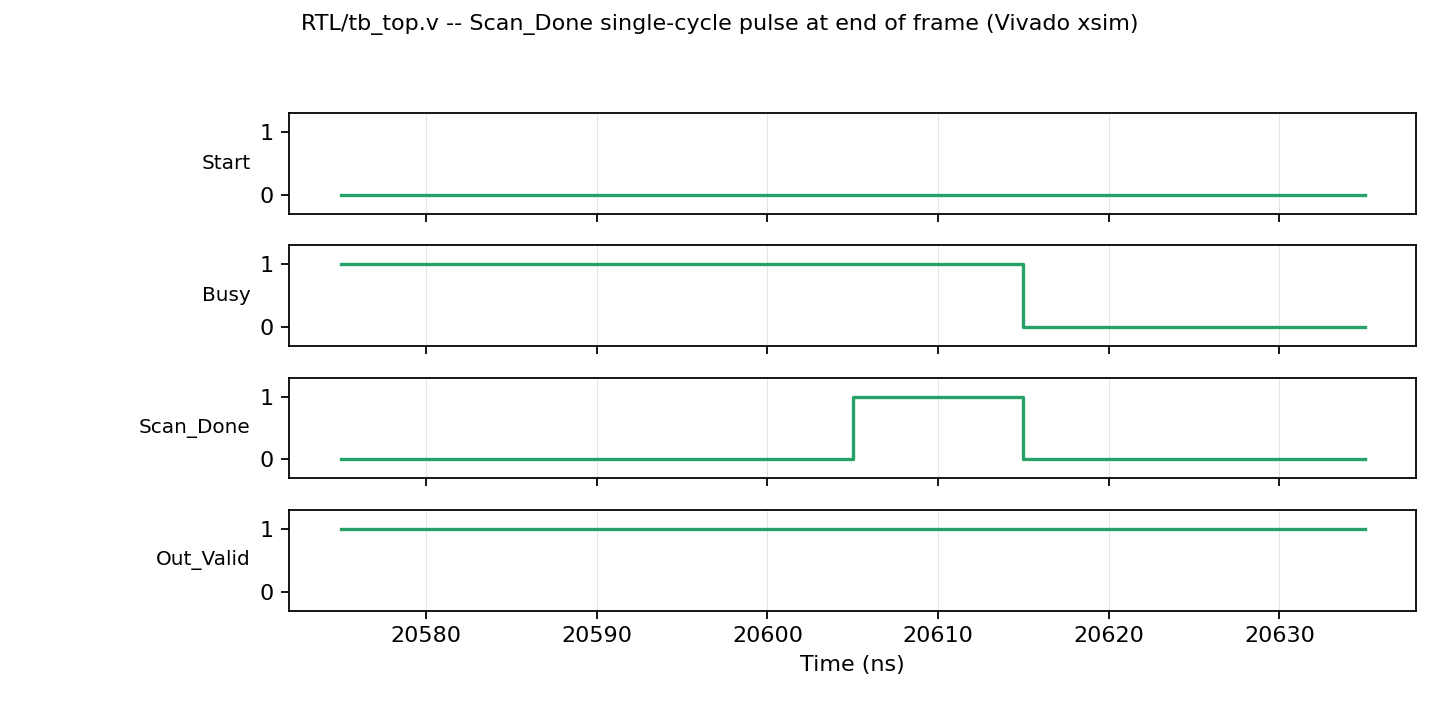
Presentation/waveform_scan_done.png
