basel-sh/CNN_Accelerator/Presentation/waveform_top_level.png

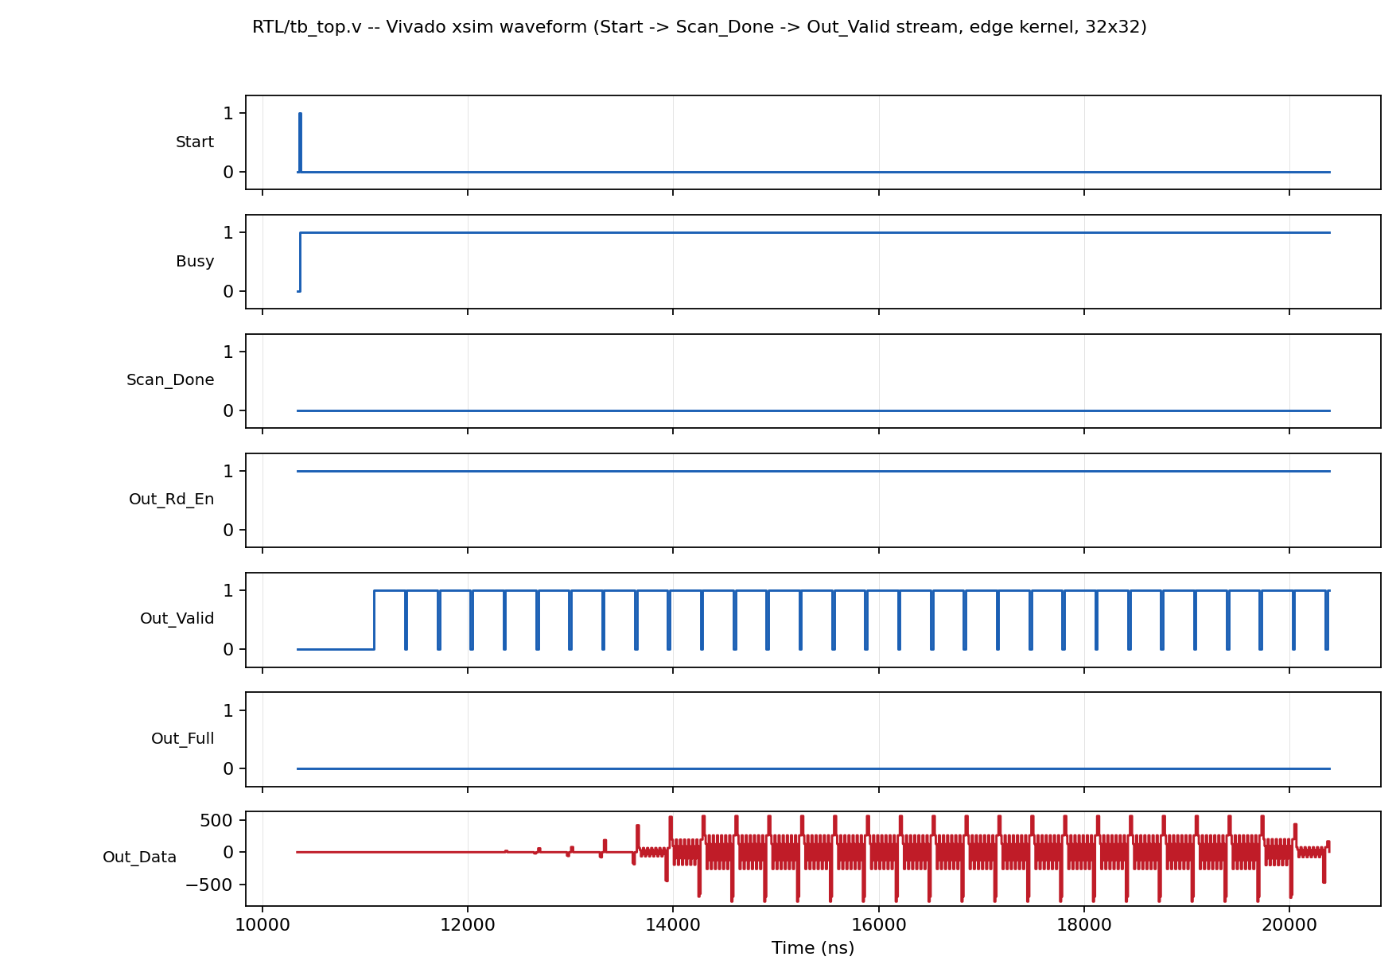
Presentation/waveform_top_level.png
