basel-sh/CNN_Accelerator/Images/Another images to test/input.png

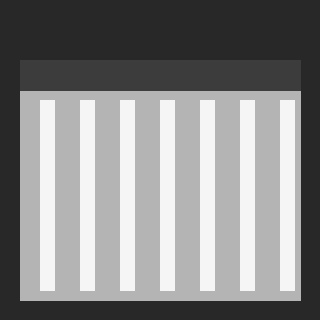
Images/Another images to test/input.png
