basel-sh/CNN_Accelerator/(commit log)

2026-07-28 Added Testing benches waves and generating output images using the golden python
    It is not working yet guys , The output image is not like what we wanted, but It seems to have the same architecture as we disccussed
    [kernel_memory.v]
2026-09-05 Optimize for FoM: right-size FIFO, tune clock, fix reset-hazard DRC warnings
    - Right-sized output FIFO (1024->16 deep), removing ~20k unnecessary FFs
    and a 1024:1 read mux caused by an oversized async-read FIFO - the real
    root cause of the original inflated LUT/FF count.
    - Set clock to 20 MHz: FoM's Throughput term is frequency-independent, so
    lowering frequency only reduces the Power term (dynamic power share).
    - Added I/O timing constraints (input/output delays, false path on async
    reset) to resolve missing-timing-reference methodology warnings.
    - Converted controller.v and line_buffer.v to synchronous reset, fixing
    DRC REQP-1840 (11 checks) and RBOR-1 (1 check) - both real hazar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
2026-09-06 Update FoM and Fmax in PerformanceResults.md with final optimized numbers
    Replace the stale pre-optimization figures (xc7a35t, 100 MHz, FoM=4.42e-4)
    with the final confirmed post-optimization run documented in
    OptimizationLog.md (xc7z020/PYNQ-Z2, 20 MHz, LUT 842, Power 0.149 W,
    Fmax ~69.1 MHz, FoM = 7.52e-3, ~19.0x improvement over baseline).
2026-09-06 Add AXI wrapper integration and clock/FIFO optimization scripts
    Wraps the accelerator with an AXI top-level block design (axi_top_wrapper.v), adds clock-lowering and design-optimization Tcl scripts, updates constraints.xdc and the project file, and includes the regenerated IP sources for the block design.
    [Table.xlsx]
2026-09-06 Add SystemVerilog/QuestaSim verification environment, verification test plan, and final competition report
    - Testbench/sv/: layered SystemVerilog environment (interface, driver,
    monitor, scoreboard, generator/env) plus mac/controller unit tests and
    an AXI4-Lite smoke test, covering all 46 rows of the verification test
    plan with code and functional coverage; run_all.do drives the full
    QuestaSim regression.
    - Verification_Test_Plan.xlsx: 46-case test plan (functional, boundary,
    reset, back-to-back, error/invalid-input, timing/protocol).
    - Final_Report_Silicon_Minds.docx: competition report covering
    architecture, fixed-point analysis, RTL implementation, verification
    methodology/r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
    [Verification_Test_Plan.xlsx]
2026-09-10 Add corrected 2px 4-DSP CNN accelerator
    [controller_2px.v, image_memory_2px.v, line_buffer_2px.v, mac_pair.v, tb_top_2px.v, top_2px.v, window_generator_2px.v]
2026-09-10 Switch MP4 top to 3-DSP timing-optimized MAC
2026-09-10 Fix slot-5 prefetch and six-cycle overlap control
2026-09-10 Add verified wrapper to MP4 simulation flow
2026-09-10 Add verified wrapper to MP4 synthesis flow
2026-09-11 2px/cycle: adopt zero-DSP top_2px, close timing, FoM 1.10e-2
    The 4-DSP MP4/MP3 datapath needed a 120 MHz second clock to share DSPs across 18 products/pair, and that clock never closed timing (WNS -4.338 ns) even though sim was bit-exact. Its FoM (8.27e-3) was only ever provisional.
    Switched to top_2px.v + mac_pair.v instead: same 20 MHz clock as everything else, 18 products done in parallel in fabric, zero DSPs, no CDC FIFOs. Routed result: LUT 1411, FF 638, DSP 0, BRAM 1.0, 0.120 W, WNS +35.076 ns (all constraints met).
    FoM = 2 / (0.120 * (1411 + 100)) = 1.10e-2, +46.6% over the 1px baseline (7.52e-3) and the first 2px/cycle result that's actually timing-closed.
    Verified 900/900 bit-exa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
2026-09-11 Reorganize Reports/ by design variant; rewrite README with real results
    Reports/{power,synthesis,timing,utilization} held the 1px baseline's reports flat at the top level while the 2px experiments each got their own subfolder (Reports/2px/, Reports/2px_mp4/) - inconsistent. Moved the baseline's reports into Reports/1px_baseline/ to match, added Reports/README.md indexing all three variants with final LUT/FF/DSP/BRAM/Power/WNS/FoM numbers.
    Rewrote the root README - it still described Phases 10-14 as pending. Updated to reflect the finished state: both branches, the FoM comparison table, and a command reference for every Tcl/Python/Vivado command used in the project.
    [Table.xlsx]
2026-09-11 Synthesis reports
    [Verification_Test_Plan.xlsx]
2026-09-11 Remove the 1px baseline and abandoned 4-DSP variant; top_2px is the only design now
    Deleted RTL/top.v, mac.v, controller.v, image_memory.v, line_buffer.v, window_generator.v, output_buffer.v, ram.v, fifo.v, axi_top_wrapper.v (the 1px baseline and its unfinished Zynq/AXI board-bringup path), plus top_2px_mp4.v, mac_pair_mp4.v, mac_pair_mp3.v, mac_pair_mp3_fixed.v, clock_5x.v (the abandoned 4-DSP/120MHz attempt that never closed timing) and their Vivado projects, testbenches, and scripts.
    Only RTL/top_2px.v + mac_pair.v + controller_2px.v + image_memory_2px.v + line_buffer_2px.v + window_generator_2px.v + kernel_memory.v remain, with Vivado_2px/ as the one Vivado project.
    Flattened Reports/2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
    [Table.xlsx]
2026-09-11 Adopt zero-DSP 2px design as the sole implementation, clean repo, extend verification
    - Remove the 1px baseline, AXI/Zynq board-bringup path, and the abandoned
    4-DSP/MP4 time-multiplexed design (never closed timing, WNS -4.338ns)
    - Keep only top_2px.v + mac_pair.v: 2 output px/cycle, zero DSPs, single
    20MHz clock, timing closed at +35.076ns
    - Final results: LUT 1411, FF 638, DSP 0, BRAM 1.0, Power 0.120W, FoM 1.10e-2
    - Consolidate Reports/ into flat utilization/timing/power folders
    - Unify RTL sim output filename (sim/rtl_output.mem) between the testbench
    and mem_to_image.py, removing the manual copy-step workaround
    - Extend golden-model verification beyond the original image/kernel pa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
    [tb_top_2px.v]
2026-09-12 Fix FIFO & MAC bugs, add AXI4-Lite, automate regression
    - Fix mac_pair.v reduction hardcoded to K=3; generalized to a parameterized loop over N=K*K terms.
    - Add fifo_pair.v (16-deep FWFT) wired into top_2px.v as U_Out_Fifo, replacing the tied-off Out_Full=0 path that silently dropped unread results.
    - Add axi_lite_top_2px.v, a self-designed AXI4-Lite register interface.
    - Add tb_axi_lite.v (12/12 checks) and rewrite tb_backpressure.v for the new FIFO.
    - Fix check() message-buffer truncation and the ID-scraping regex across all testbenches.
    - Add run_all.py, a single-command regression: unit tests, FIFO/AXI checks, golden-model diffs, and spreadsheet write-back.
    - Update Verification_Te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
    [Verification_Test_Plan.xlsx]
2026-09-12 Optimization for Design
    Narrow Kernel_W/Acc_W to 4/16 bits, cut LUT 1605->918 (FoM +80.9%)
    Restrict kernel coefficients to |coeff| <= 8 (from full 8-bit signed) to
    shrink the 18 fabric multiplies dominating LUT usage in mac_pair.v.
    This is a hardware-enforced limit, not an assumption: Kernel_W cut to 4
    bits so an out-of-range coefficient cannot be loaded into
    kernel_memory.v at all. Acc_W re-derived from that real range (worst
    sum 9*255*8=18,360 < 32,767) to 16 bits, meeting the competition's
    16-bit minimum exactly.
    RTL:
    - top_2px.v, mac_pair.v: Kernel_W 8->4, Acc_W 20->16
    - kernel_memory.v: Kernel_W 8->4
    Kept in lockstep to avoid silently misinterpreting kernel values
    (same bug class as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
2026-09-13 Updating Reports
    [Verification_Test_Plan.xlsx]
2026-09-14 Fixing the hardcoded Width 20 in the testing and finalizing the report and the readme file
    [Verification_Test_Plan.xlsx]
